hedrickbt/CentralCommand/hardware/assembly/v1/cc_v1_with_stencil.JPG

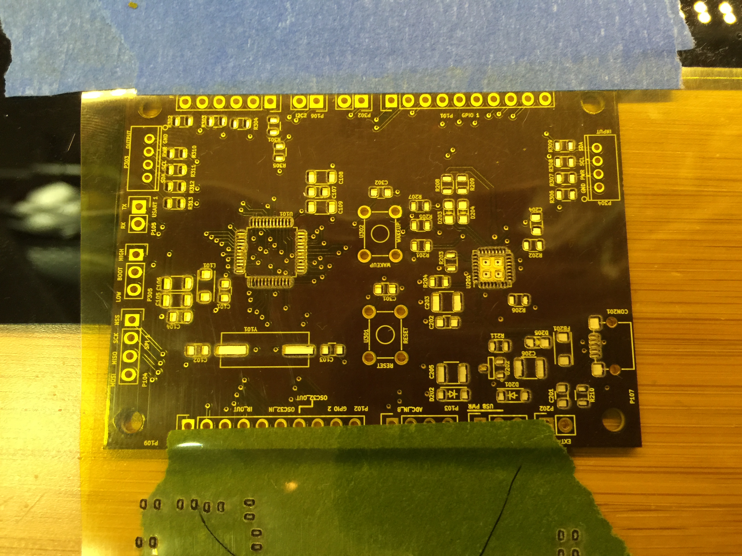
hardware/assembly/v1/cc_v1_with_stencil.JPG
