hedrickbt/CentralCommand/hardware/assembly/v1/cc_v1_final_assembly.JPG

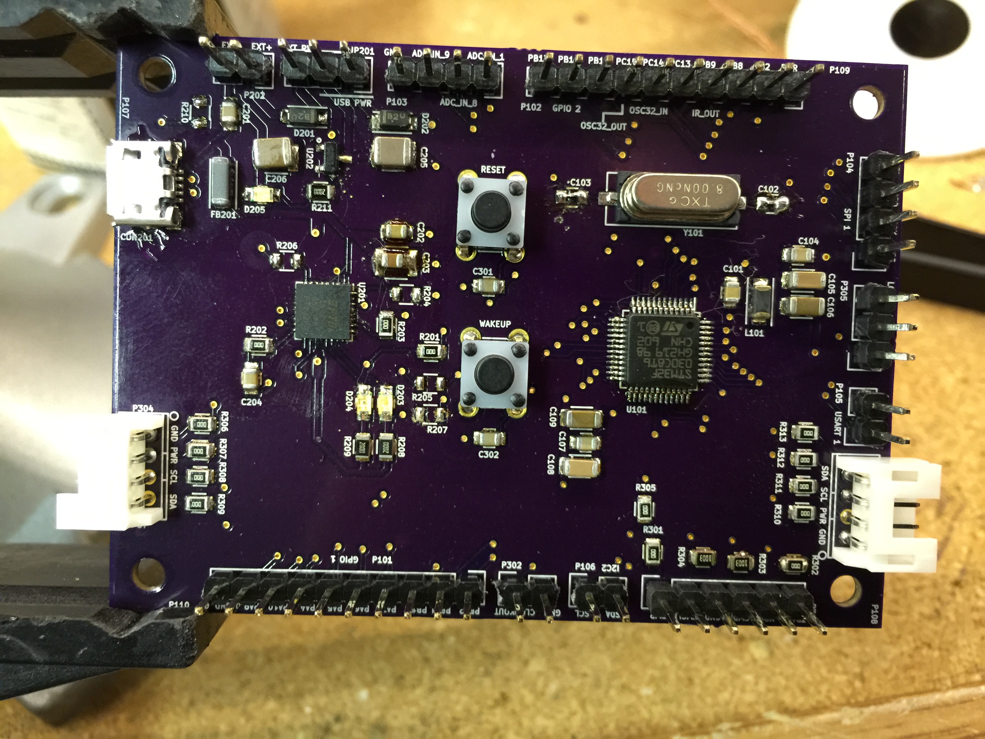
hardware/assembly/v1/cc_v1_final_assembly.JPG
