hedrickbt/CentralCommand/README.md

# CentralCommand
Contextual Electronics CentralCommand project
