hedrickbt/CentralCommand/hardware/assembly/v1/cc_v1_with_paste_and_some_parts.JPG

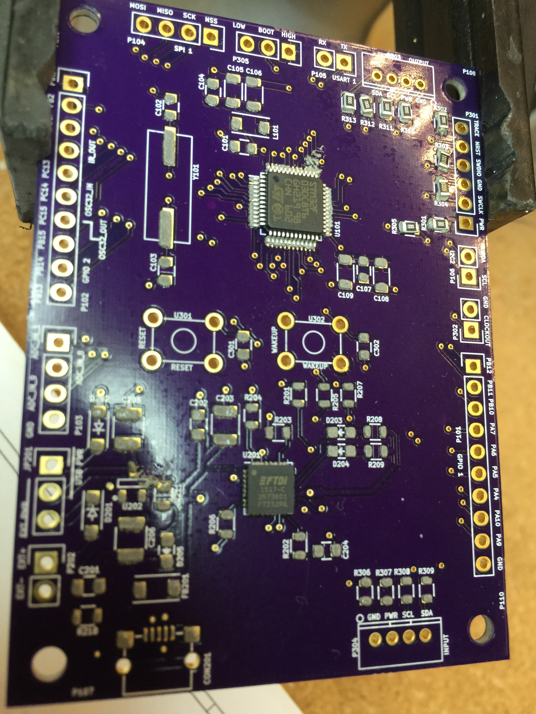
hardware/assembly/v1/cc_v1_with_paste_and_some_parts.JPG
