hedrickbt/CentralCommand/hardware/stencil/v2/CentralCommandStencil.dxf

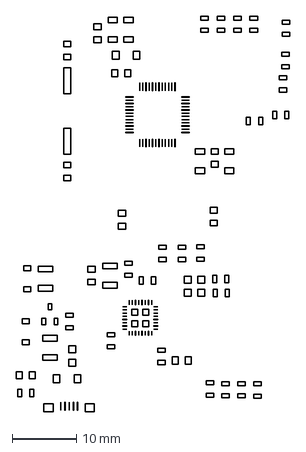
[picture p4: CAD file, 2016-12-29]
hardware/stencil/v2/CentralCommandStencil.dxf
42.4 x 61.4 mm
