hedrickbt/CentralCommand/hardware/gerber/v1/laser/laser_cut_paste_stencil.dxf

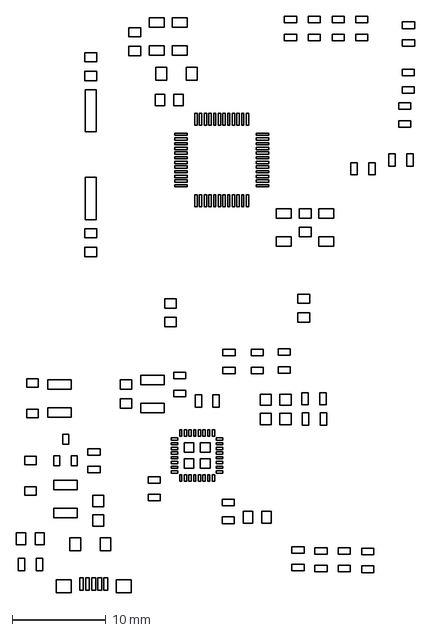
[picture p5: CAD file, 2016-12-29, an earlier design]
hardware/gerber/v1/laser/laser_cut_paste_stencil.dxf
42.5 x 61.5 mm
