hedrickbt/CentralCommand/hardware/pcb/CentralCommand.kicad_pcb

## KiCad design hardware/pcb/CentralCommand.kicad_pcb (2017-01-05)

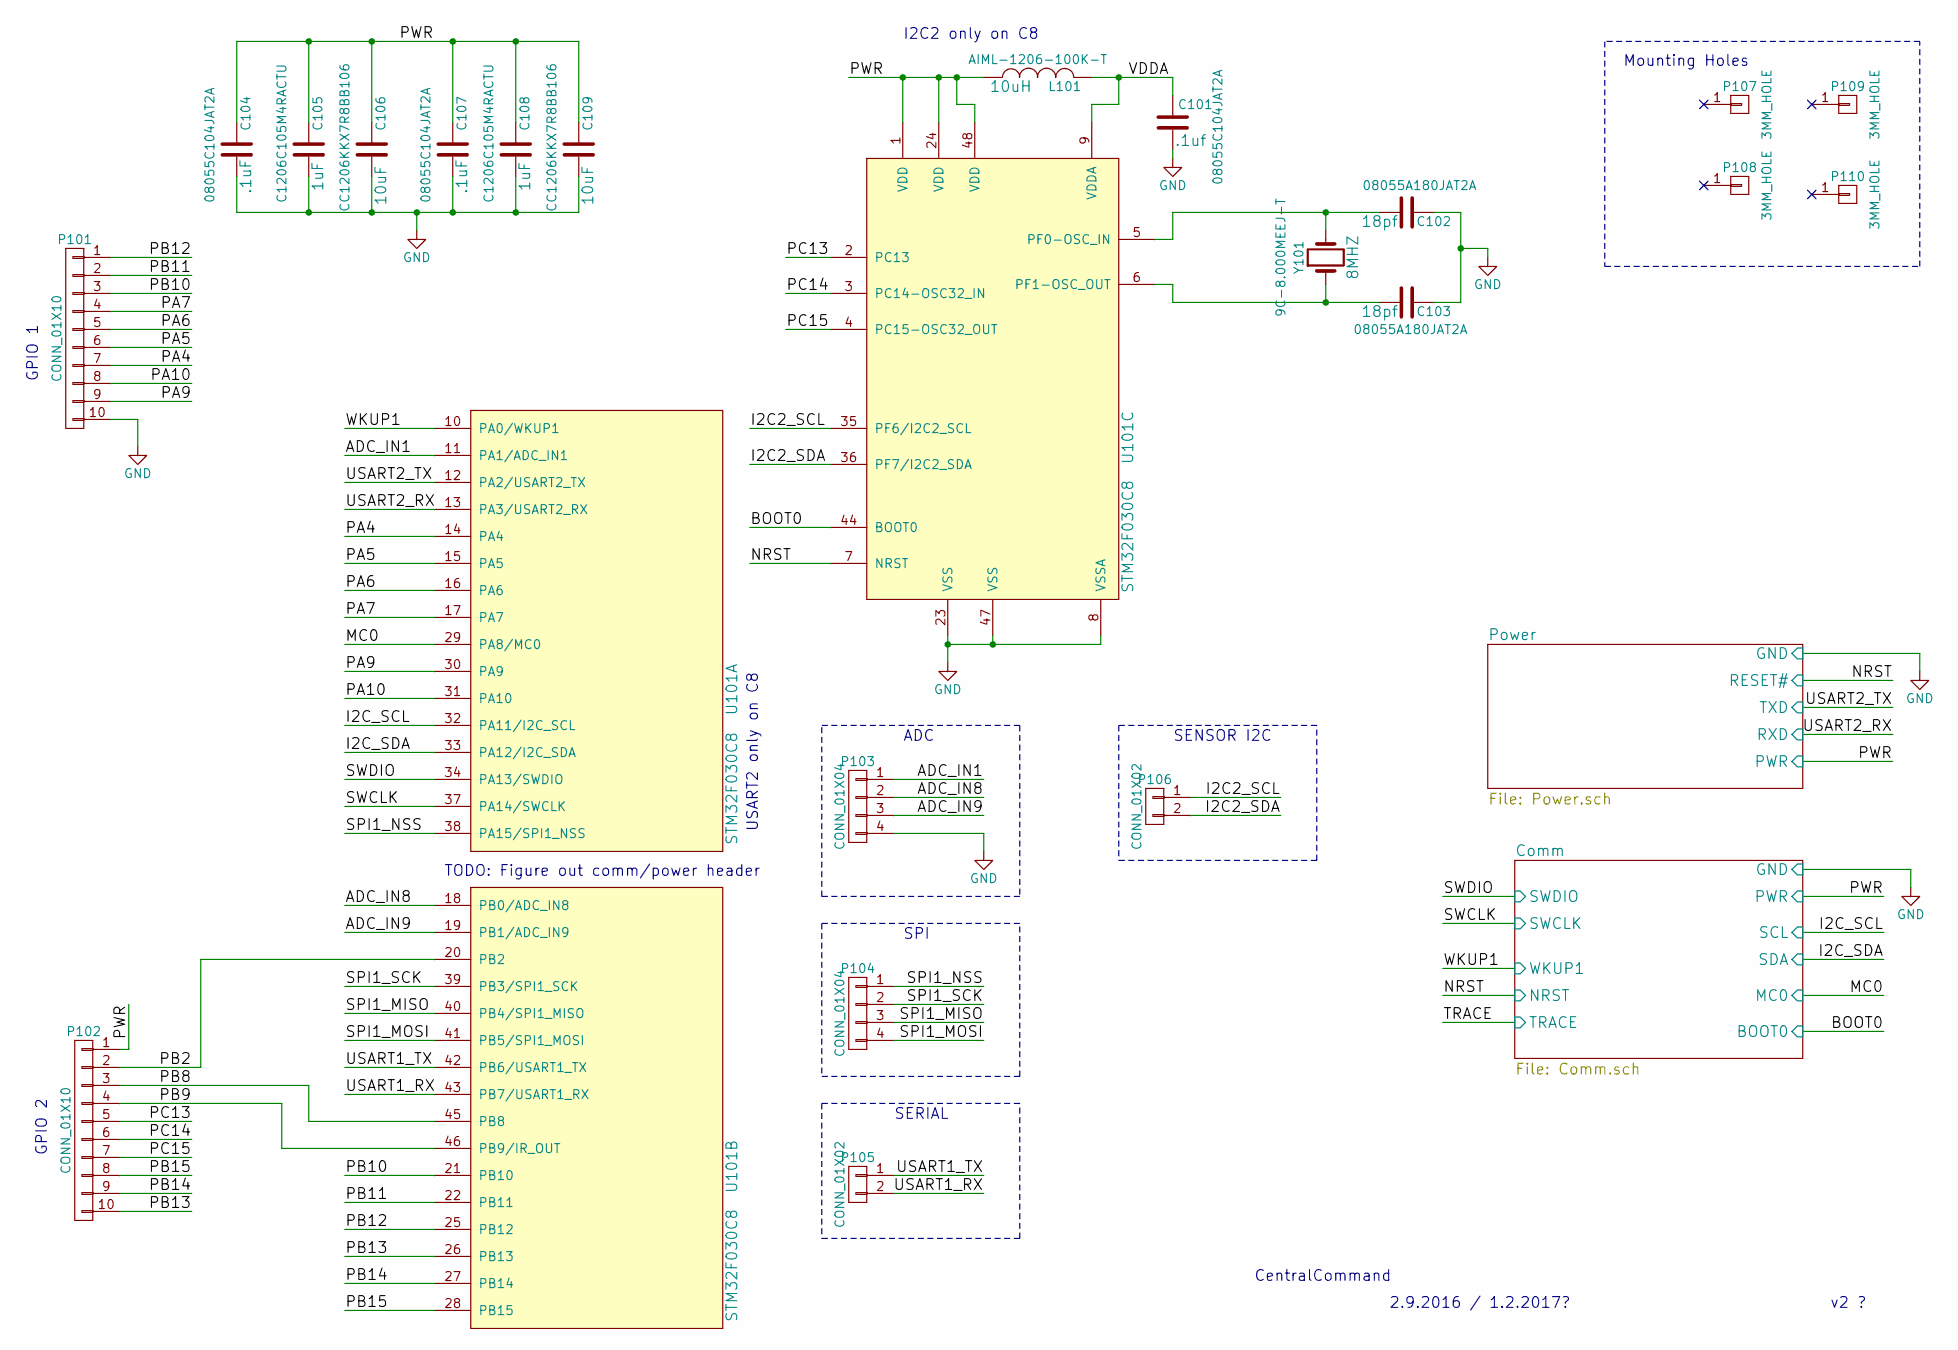
[picture p6: schematic CentralCommand.sch]

Parts:
C101, C104, C107: 08055C104JAT2A; C_0805; MPN 08055C104JAT2A
C102, C103: 08055A180JAT2A; C_0805; MPN 08055A180JAT2A
C105, C108: C1206C105M4RACTU; C_1206; MPN C1206C105M4RACTU
C106, C109: CC1206KKX7R8BB106; C_1206; MPN CC1206KKX7R8BB106
L101: AIML-1206-100K-T; Neosid_Inductor_SM1206; MPN AIML-1206-100K-T
P101, P102: CONN_01X10; Pin_Header_Straight_1x10
P103, P104: CONN_01X04; Pin_Header_Straight_1x04
P105, P106: CONN_01X02; Pin_Header_Straight_1x02
P107, P108, P109, P110: 3MM_HOLE; MountingHole_3mm
U101: STM32F030C8; LQFP-48_7x7mm_Pitch0.5mm; MPN STM32F030C8T6
Y101: 9C-8.000MEEJ-T; Crystal_HC49_US; MPN 9C-8.000MEEJ-T

Connections:
/ADC_IN1: P103.1, U101.11 (PA1/ADC_IN1)
/ADC_IN8: P103.2, U101.18 (PB0/ADC_IN8)
/ADC_IN9: P103.3, U101.19 (PB1/ADC_IN9)
/BOOT0: U101.44 (BOOT0); also elsewhere on the board
/I2C2_SCL: P106.1, U101.35 (PF6/I2C2_SCL)
/I2C2_SDA: P106.2, U101.36 (PF7/I2C2_SDA)
/I2C_SCL: U101.32 (PA11/I2C_SCL); also elsewhere on the board
/I2C_SDA: U101.33 (PA12/I2C_SDA); also elsewhere on the board
/MC0: U101.29 (PA8/MC0); also elsewhere on the board
/NRST: U101.7 (NRST); also elsewhere on the board
/PA4: P101.7, U101.14 (PA4)
/PA5: P101.6, U101.15 (PA5)
/PA6: P101.5, U101.16 (PA6)
/PA7: P101.4, U101.17 (PA7)
/PA9: P101.9, U101.30 (PA9)
/PA10: P101.8, U101.31 (PA10)
/PB2: P102.2, U101.20 (PB2)
/PB8: P102.3, U101.45 (PB8)
/PB9: P102.4, U101.46 (PB9/IR_OUT)
/PB10: P101.3, U101.21 (PB10)
/PB11: P101.2, U101.22 (PB11)
/PB12: P101.1, U101.25 (PB12)
/PB13: P102.10, U101.26 (PB13)
/PB14: P102.9, U101.27 (PB14)
/PB15: P102.8, U101.28 (PB15)
/PC13: P102.5, U101.2 (PC13)
/PC14: P102.6, U101.3 (PC14-OSC32_IN)
/PC15: P102.7, U101.4 (PC15-OSC32_OUT)
/PWR: C104.1, C105.1, C106.1, C107.1, C108.1, C109.1, L101.1, P102.1, U101.1 (VDD), U101.24 (VDD), U101.48 (VDD); also elsewhere on the board
/SPI1_MISO: P104.3, U101.40 (PB4/SPI1_MISO)
/SPI1_MOSI: P104.4, U101.41 (PB5/SPI1_MOSI)
/SPI1_NSS: P104.1, U101.38 (PA15/SPI1_NSS)
/SPI1_SCK: P104.2, U101.39 (PB3/SPI1_SCK)
/SWCLK: U101.37 (PA14/SWCLK); also elsewhere on the board
/SWDIO: U101.34 (PA13/SWDIO); also elsewhere on the board
/USART1_RX: P105.2, U101.43 (PB7/USART1_RX)
/USART1_TX: P105.1, U101.42 (PB6/USART1_TX)
/USART2_RX: U101.13 (PA3/USART2_RX); also elsewhere on the board
/USART2_TX: U101.12 (PA2/USART2_TX); also elsewhere on the board
/VDDA: C101.1, L101.2, U101.9 (VDDA)
/WKUP1: U101.10 (PA0/WKUP1); also elsewhere on the board
GND: C101.2, C102.1, C103.1, C104.2, C105.2, C106.2, C107.2, C108.2, C109.2, P101.10, P103.4, U101.8 (VSSA), U101.23 (VSS), U101.47 (VSS); also elsewhere on the board
unnamed: C102.2, U101.5 (PF0-OSC_IN), Y101.2
unnamed: C103.2, U101.6 (PF1-OSC_OUT), Y101.1

Notes on the sheet:
CentralCommand
v2 ?
2.9.2016 / 1.2.2017?
USART2 only on C8
I2C2 only on C8
TODO: Figure out comm/power header
GPIO 1
GPIO 2
SPI
ADC
SENSOR I2C
SERIAL
Mounting Holes

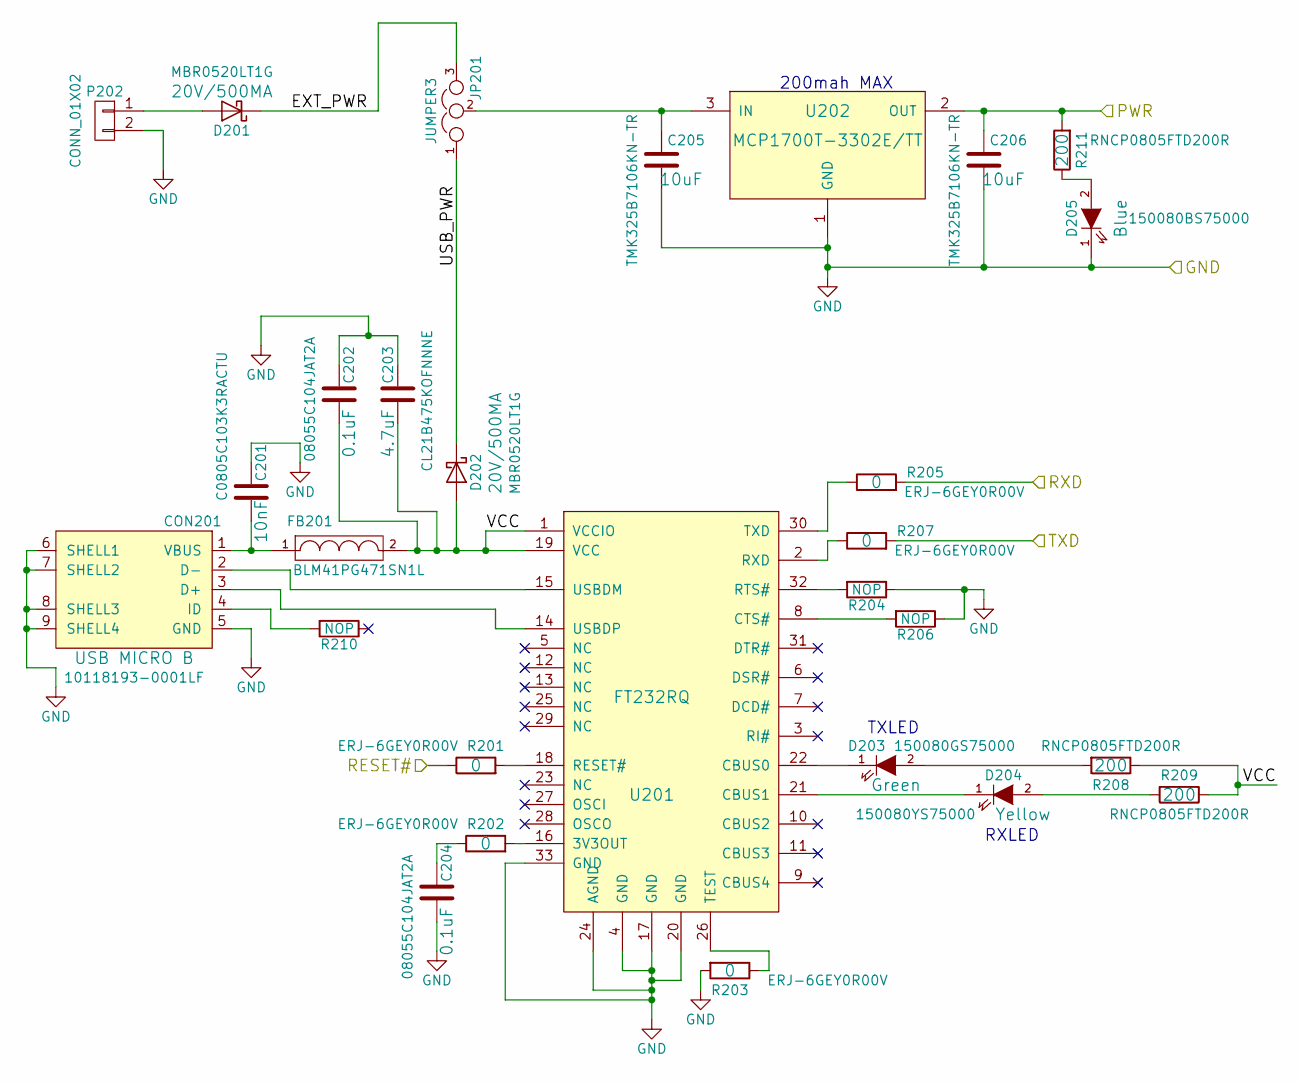
[picture p7: schematic Power.sch]

Parts:
C201: C0805C103K3RACTU; C_0805; MPN C0805C103K3RACTU
C202, C204: 08055C104JAT2A; C_0805; MPN 08055C104JAT2A
C203: CL21B475KOFNNNE; C_0805; MPN CL21B475KOFNNNE
C205, C206: TMK325B7106KN-TR; C_1210; MPN TMK325B7106KN-TR
CON201: 10118193-0001LF; MICRO_B_CONN_10118193-0001LF; MPN 10118193-0001LF
D201, D202: MBR0520LT1G; SOD-123; MPN MBR0520LT1G
D203: 150080GS75000; LED_0805; MPN 150080GS75000
D204: 150080YS75000; LED_0805; MPN 150080YS75000
D205: 150080BS75000; LED_0805; MPN 150080BS75000
FB201: BLM41PG471SN1L; Filter_SM1806; MPN BLM41PG471SN1L
JP201: JUMPER3; Pin_Header_Straight_1x03
P202: CONN_01X02; Pin_Header_Straight_1x02
R201, R202, R203, R205, R207: ERJ-6GEY0R00V; R_0805; MPN ERJ-6GEY0R00V
R204, R206, R210: NOP; R_0805
R208, R209, R211: RNCP0805FTD200R; R_0805; MPN RNCP0805FTD200R
U201: FT232RQ; QFN-32-1EP_5x5mm_Pitch0.5mm; MPN FT232RQ-REEL
U202: MCP1700T-3302E/TT; SOT-23; MPN MCP1700T-3302E/TT

Connections:
/NRST: R201.1; also elsewhere on the board
/PWR: C206.1, R211.2, U202.2 (OUT); also elsewhere on the board
/Power/EXT_PWR: D201.1 (K), JP201.3
/Power/USB_PWR: D202.1 (K), JP201.1
/Power/VCC: C202.2, C203.2, D202.2 (A), FB201.2, R208.1, R209.1, U201.1 (VCCIO), U201.19 (VCC)
/USART2_RX: R205.2; also elsewhere on the board
/USART2_TX: R207.2; also elsewhere on the board
GND: C201.1, C202.1, C203.1, C204.2, C205.2, C206.2, CON201.5 (GND), CON201.6 (SHELL1), CON201.7 (SHELL2), CON201.8 (SHELL3), CON201.9 (SHELL4), D205.1 (K), P202.2, R203.2, R204.1, R206.1, U201.4 (GND), U201.17 (GND), U201.20 (GND), U201.24 (AGND), U201.33 (GND), U202.1 (GND); also elsewhere on the board
unnamed: C201.2, CON201.1 (VBUS), FB201.1
unnamed: C204.1, R202.1
unnamed: C205.1, JP201.2, U202.3 (IN)
unnamed: CON201.2 (D-), U201.15 (USBDM)
unnamed: CON201.3 (D+), U201.14 (USBDP)
unnamed: CON201.4 (ID), R210.2
unnamed: D201.2 (A), P202.1
unnamed: D203.1 (K), U201.22 (CBUS0)
unnamed: D203.2 (A), R208.2
unnamed: D204.1 (K), U201.21 (CBUS1)
unnamed: D204.2 (A), R209.2
unnamed: D205.2 (A), R211.1
unnamed: R201.2, U201.18 (RESET#)
unnamed: R202.2, U201.16 (3V3OUT)
unnamed: R203.1, U201.26 (TEST)
unnamed: R204.2, U201.32 (RTS#)
unnamed: R205.1, U201.30 (TXD)
unnamed: R206.2, U201.8 (CTS#)
unnamed: R207.1, U201.2 (RXD)

Notes on the sheet:
200mah MAX
TXLED
RXLED

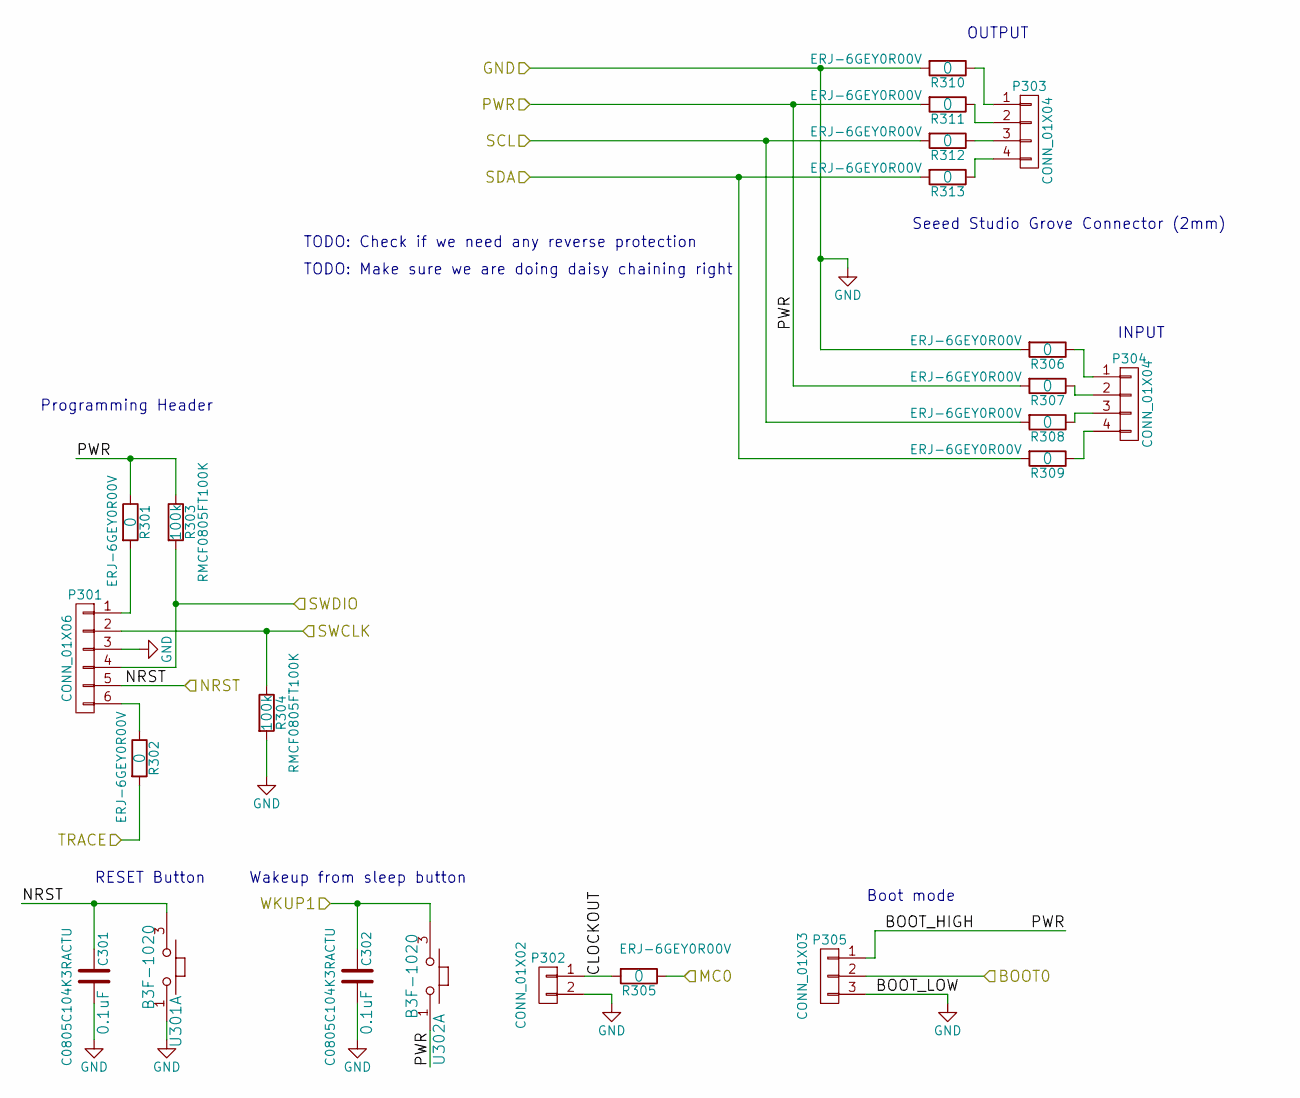
[picture p8: schematic Comm.sch]

Parts:
C301, C302: C0805C104K3RACTU; C_0805; MPN C0805C104K3RACTU
P301: CONN_01X06; Pin_Header_Straight_1x06
P302: CONN_01X02; Pin_Header_Straight_1x02
P303, P304: CONN_01X04; GroveConnectorStraight_B4B-PH-K-S; MPN S4B-PH-K-S(LF)(SN)
P305: CONN_01X03; Pin_Header_Straight_1x03
R301, R302, R305, R306, R307, R308, R309, R310, R311, R312, R313: ERJ-6GEY0R00V; R_0805; MPN ERJ-6GEY0R00V
R303, R304: RMCF0805FT100K; C_0805; MPN RMCF0805FT100K
U301, U302: B3F-1020; Pushbutton_B3F-1020; MPN B3F-1020

Connections:
/BOOT0: P305.2; also elsewhere on the board
/Comm/CLOCKOUT: P302.1, R305.2
/I2C_SCL: R308.2, R312.2; also elsewhere on the board
/I2C_SDA: R309.2, R313.2; also elsewhere on the board
/MC0: R305.1; also elsewhere on the board
/NRST: C301.1, P301.5, U301.3; also elsewhere on the board
/PWR: P305.1, R301.1, R303.1, R307.2, R311.2, U302.1; also elsewhere on the board
/SWCLK: P301.2, R304.1; also elsewhere on the board
/SWDIO: P301.4, R303.2; also elsewhere on the board
/TRACE: R302.2
/WKUP1: C302.1, U302.3; also elsewhere on the board
GND: C301.2, C302.2, P301.3, P302.2, P305.3, R304.2, R306.2, R310.2, U301.1; also elsewhere on the board
unnamed: P301.1, R301.2
unnamed: P301.6, R302.1
unnamed: P303.1, R310.1
unnamed: P303.2, R311.1
unnamed: P303.3, R312.1
unnamed: P303.4, R313.1
unnamed: P304.1, R306.1
unnamed: P304.2, R307.1
unnamed: P304.3, R308.1
unnamed: P304.4, R309.1

Notes on the sheet:
Seeed Studio Grove Connector (2mm)
TODO: Check if we need any reverse protection
TODO: Make sure we are doing daisy chaining right
RESET Button
Programming Header
Wakeup from sleep button
Boot mode
OUTPUT
INPUT

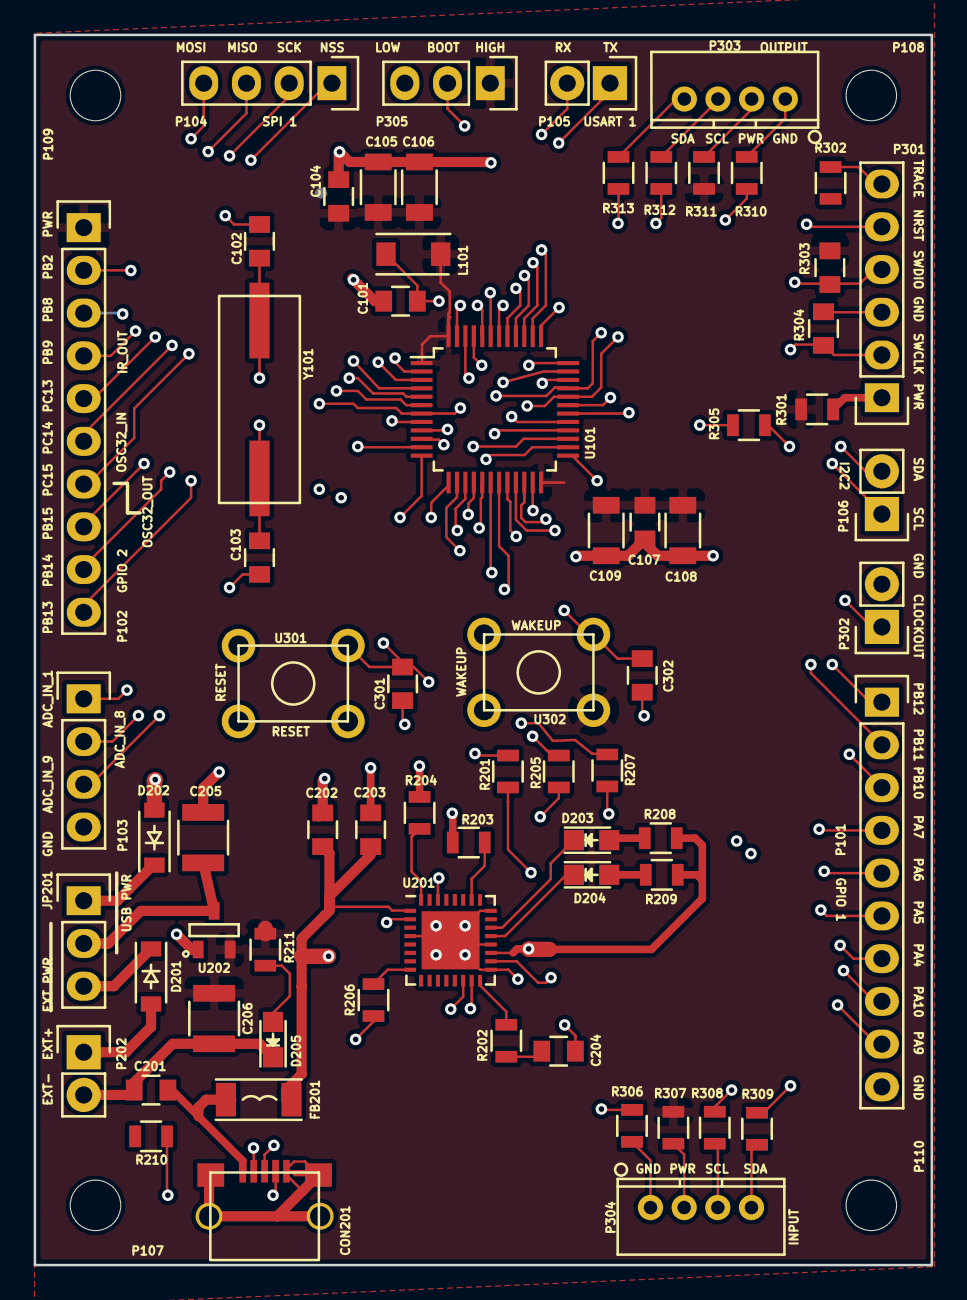
[picture p9: board CentralCommand.kicad_pcb from above]

Board: 4 copper layers, 53.3 x 73.1 mm, 72 parts (0 on the bottom side), 77 nets.
