hedrickbt/CentralCommand/hardware/assembly/v1/readme.txt

[url=https://flic.kr/p/GJxV3V][img]https://farm2.staticflickr.com/1542/26735790485_2bdbbd0ffa.jpg[/img][/url][url=https://flic.kr/p/GJxV3V]cc_v1_final_assembly[/url] by [url=https://www.flickr.com/photos/131936024@N04/]Brooke Hedrick[/url], on Flickr
[url=https://flic.kr/p/GGhb1f][img]https://farm2.staticflickr.com/1668/26710086006_3a47fb60d0.jpg[/img][/url][url=https://flic.kr/p/GGhb1f]cc_v1_b4_stencil[/url] by [url=https://www.flickr.com/photos/131936024@N04/]Brooke Hedrick[/url], on Flickr
[url=https://flic.kr/p/GJxVat][img]https://farm2.staticflickr.com/1500/26735790865_e563805fd6.jpg[/img][/url][url=https://flic.kr/p/GJxVat]cc_v1_0201_cap_doh[/url] by [url=https://www.flickr.com/photos/131936024@N04/]Brooke Hedrick[/url], on Flickr
[url=https://flic.kr/p/GGhbaJ][img]https://farm2.staticflickr.com/1678/26710086556_d40fbe3a1b.jpg[/img][/url][url=https://flic.kr/p/GGhbaJ]cc_v1_with_stencil[/url] by [url=https://www.flickr.com/photos/131936024@N04/]Brooke Hedrick[/url], on Flickr
[url=https://flic.kr/p/GJxVgv][img]https://farm2.staticflickr.com/1486/26735791215_5d07b2f7e9.jpg[/img][/url][url=https://flic.kr/p/GJxVgv]cc_v1_with_paste_and_some_parts[/url] by [url=https://www.flickr.com/photos/131936024@N04/]Brooke Hedrick[/url], on Flickr
[url=https://flic.kr/p/GjtWZY][img]https://farm2.staticflickr.com/1585/26463420690_286c540dd1.jpg[/img][/url][url=https://flic.kr/p/GjtWZY]cc_v1_0201_cap_doh_zoom_annot[/url] by [url=https://www.flickr.com/photos/131936024@N04/]Brooke Hedrick[/url], on Flickr
