hedrickbt/CentralCommand/hardware/assembly/v1/cc_v1_0201_cap_doh.JPG

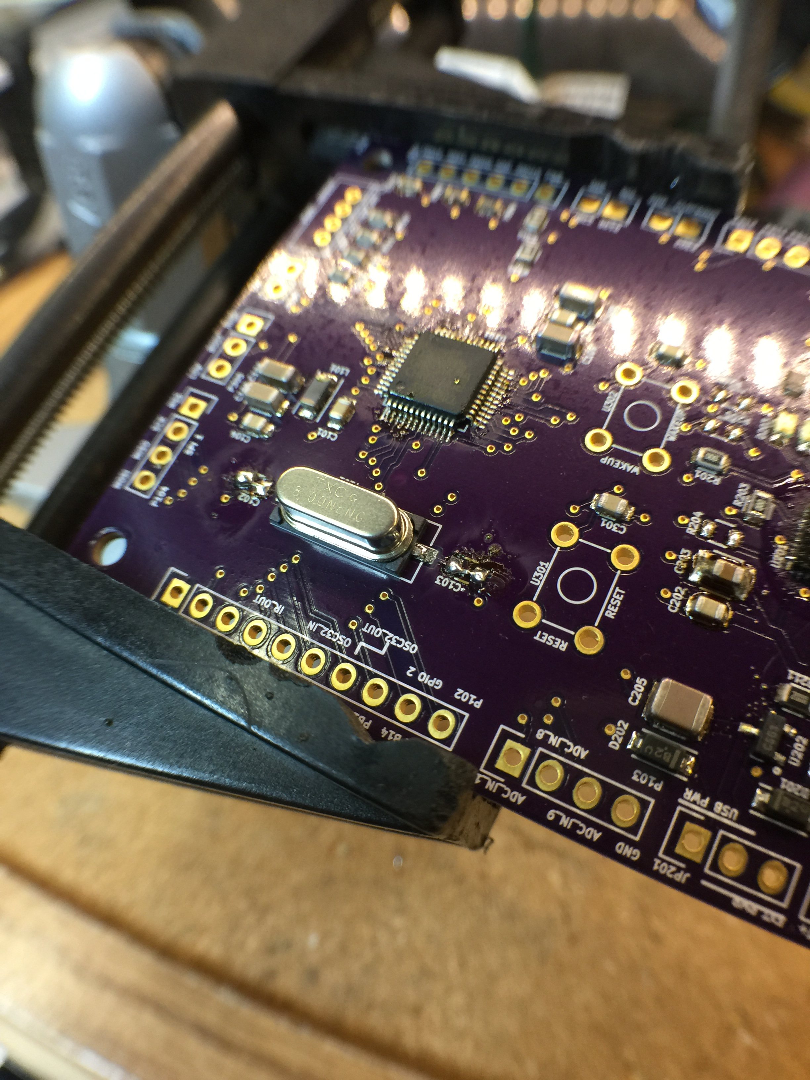
hardware/assembly/v1/cc_v1_0201_cap_doh.JPG
