hedrickbt/CentralCommand/hardware/assembly/v1/cc_v1_0201_cap_doh_zoom.jpg

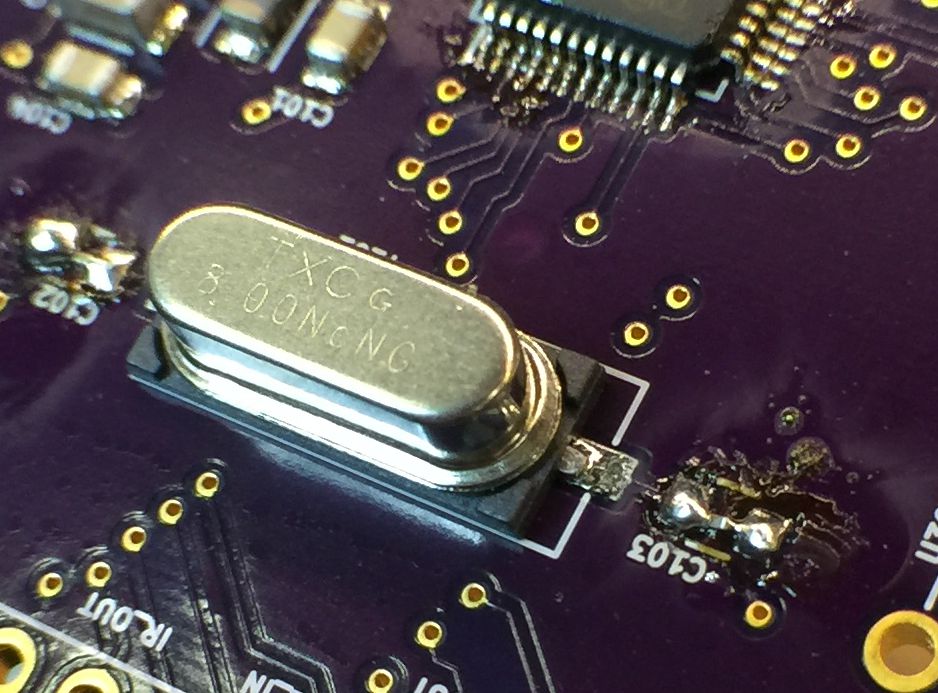
hardware/assembly/v1/cc_v1_0201_cap_doh_zoom.jpg
