hedrickbt/CentralCommand/hardware/assembly/v1/cc_v1_b4_stencil.JPG

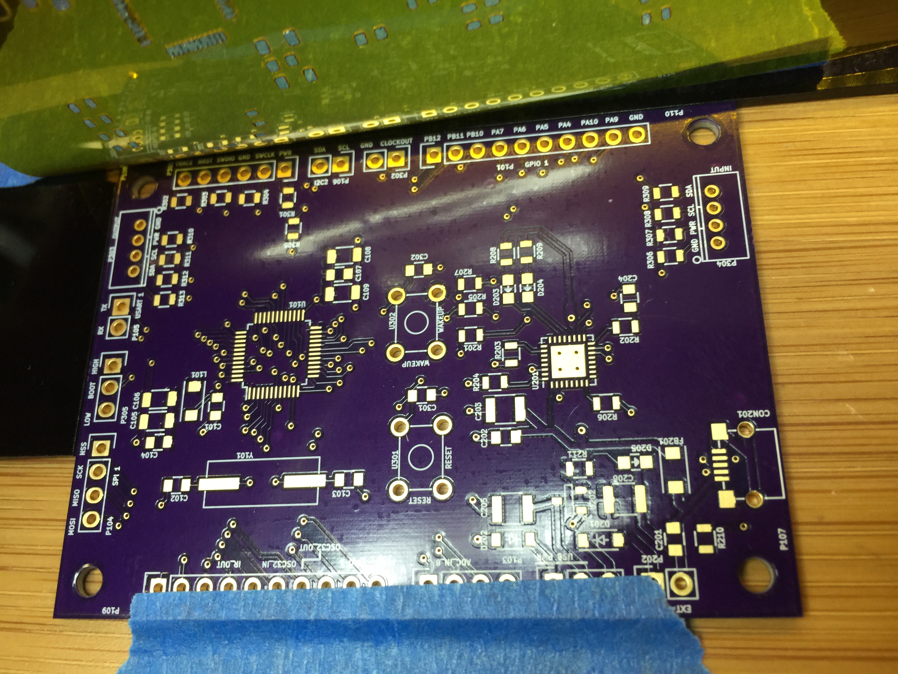
hardware/assembly/v1/cc_v1_b4_stencil.JPG
