hedrickbt/CentralCommand/(commit log)

2016-12-29 Moving items around
    [CentralCommand-B.Cu.gbl, CentralCommand-B.Mask.gbs, CentralCommand-B.Paste.gbp, CentralCommand-B.SilkS.gbo, CentralCommand-Edge.Cuts.gm1, CentralCommand-F.Cu.gtl, CentralCommand-F.Mask.gts, CentralCommand-F.Paste.gtp]
2016-12-29 Opened and saved with KiCad 4.0.5
    [CentralCommand.sch, Comm.sch, Power.sch]
2017-01-02 Re-reading the netlist in pcbnew broke the Front CU as KiCad has changed the sheet mapping of nets. /comm/pwr became just /pwr. I had to associate /pwr to the Front CU.
    [CentralCommand.kicad_pcb]
